usatiuk/EggbotWireless/Electronics/EggbotWireless/EggbotWirelessBOM.xlsx

Sheet: Sheet1
Column1 | Column2 | Column3 | Column4
Source: | C:\Users\stepu\projects\EggbotWireless\Electronics\EggbotWireless\EggbotWireless.sch
Date: | 17.03.2020 17:32:18
Tool: | Eeschema (5.1.5)-3
Generator: | C:\Program Files\KiCad\bin\scripting\plugins/bom_csv_grouped_by_value.py
Component Count: | 90
Individual Components:
Item | Qty | Reference(s) | Value
 |  | A1 | Pololu_Breakout_DRV8825
 |  | A2 | Pololu_Breakout_DRV8825
 |  | C1 | 22pF
 |  | C2 | 4.7uF
 |  | C3 | 22pF
 |  | C4 | 100nf
 |  | C5 | 10uF
 |  | C6 | 3300pF
 |  | C7 | 100nf
 |  | C8 | 100nf
 |  | C9 | 68nF
 |  | C10 | 100nf
 |  | C11 | 10pF
 |  | C12 | 220uF
 |  | C13 | 220uF
 |  | C14 | 100nf
 |  | C15 | 100nf
 |  | C16 | 100nf
 |  | C17 | 10uF
 |  | C18 | 10uF
 |  | C19 | 22pF
 |  | C20 | 100nF
 |  | C21 | 10uF
 |  | D1 | SSB43L
 |  | D2 | SSB43L
 |  | D3 | LED
 |  | D4 | SSB43L
 |  | D5 | SSB43L
 |  | J1 | BATT
 |  | J2 | Conn_01x03_Male
 |  | J3 | USB_B_Micro
 |  | J4 | AVR-ISP-6
 |  | J5 | Conn_01x03_Female
 |  | J6 | Conn_01x05_Male
 |  | JP1 | SolderJumper_2_Bridged
 |  | JP2 | SolderJumper_2_Bridged
 |  | JP3 | SolderJumper_2_Bridged
 |  | L1 | 6.8uH
 |  | L2 | 10uH
 |  | L3 | 6.8uH
 |  | M1
 |  | M2
 |  | M3 | Motor_Servo
 |  | Q1 | FDD8800
 |  | Q2 | 2N7002
 |  | Q3 | IRLML6402
 |  | Q4 | IRLML6402
 |  | Q5 | S8050
 |  | Q6 | S8050
 |  | R1 | 10K
 |  | R2 | 100
 |  | R3 | 1K
 |  | R4 | 1.8K
 |  | R5 | 1K
 |  | R6 | 10K
 |  | R7 | 2.2K
 |  | R8 | 10K
 |  | R9 | 10K
 |  | R10 | 10K
 |  | R11 | 10K
 |  | R12 | 10K
 |  | R13 | 27K
 |  | R14 | 100
 |  | R15 | 0.008
 |  | R16 | 8.45K
 |  | R17 | 10K
 |  | R18 | 10K
 |  | R19 | 10K
 |  | R20 | 10K
 |  | R21 | 510
 |  | R22 | 10K
 |  | R23 | 50K
 |  | R24 | 12K
 |  | R25 | 12K
 |  | R26 | 12K
 |  | R27 | 2.2K
 |  | R28 | 150K
 |  | R29 | 200K
 |  | R30 | 500
 |  | SW1
 |  | U1 | TPS62203DBV
 |  | U2 | ATmega328P-AU
 |  | U3 | DW01
 |  | U4 | DMG4800LSD
 |  | U5 | FT232RL
 |  | U6 | LTC4054ES5-4.2
 |  | U7 | ESP-12E
 |  | U8 | LM3478
 |  | U9 | LM2621
 |  | Y1 | 16MHz
Collated Components:
Item | Qty | Reference(s) | Value
1 | 2 | A1, A2 | Pololu_Breakout_DRV8825
2 | 3 | C1, C3, C19 | 22pF
3 | 1 | C2 | 4.7uF
4 | 7 | C4, C7, C8, C10, C14, C15, C16 | 100nf
5 | 2 | C5, C17 | 10uF
6 | 1 | C6 | 3300pF
7 | 1 | C9 | 68nF
8 | 1 | C11 | 10pF
9 | 2 | C12, C13 | 220uF
10 | 2 | C18, C21 | 10uF
11 | 1 | C20 | 100nF
12 | 4 | D1, D2, D4, D5 | SSB43L
13 | 1 | D3 | LED
14 | 1 | J1 | BATT
15 | 1 | J2 | Conn_01x03_Male
16 | 1 | J3 | USB_B_Micro
17 | 1 | J4 | AVR-ISP-6
18 | 1 | J5 | Conn_01x03_Female
19 | 1 | J6 | Conn_01x05_Male
20 | 3 | JP1, JP2, JP3 | SolderJumper_2_Bridged
21 | 1 | L1 | 6.8uH
22 | 1 | L2 | 10uH
23 | 1 | L3 | 6.8uH
24 | 2 | M1, M2
25 | 1 | M3 | Motor_Servo
26 | 1 | Q1 | FDD8800
27 | 1 | Q2 | 2N7002
28 | 2 | Q3, Q4 | IRLML6402
29 | 2 | Q5, Q6 | S8050
30 | 11 | R1, R6, R8, R9, R10, R11, R12, R17, R18, R20, R22 | 10K
31 | 1 | R2 | 100
32 | 1 | R3 | 1K
33 | 1 | R4 | 1.8K
34 | 1 | R5 | 1K
35 | 2 | R7, R27 | 2.2K
36 | 1 | R13 | 27K
37 | 1 | R14 | 100
38 | 1 | R15 | 0.008
39 | 1 | R16 | 8.45K
40 | 1 | R19 | 10K
41 | 1 | R21 | 510
42 | 1 | R23 | 50K
43 | 3 | R24, R25, R26 | 12K
44 | 1 | R28 | 150K
45 | 1 | R29 | 200K
46 | 1 | R30 | 500
47 | 1 | SW1
48 | 1 | U1 | TPS62203DBV
49 | 1 | U2 | ATmega328P-AU
50 | 1 | U3 | DW01
51 | 1 | U4 | DMG4800LSD
52 | 1 | U5 | FT232RL
53 | 1 | U6 | LTC4054ES5-4.2
54 | 1 | U7 | ESP-12E
55 | 1 | U8 | LM3478
56 | 1 | U9 | LM2621
57 | 1 | Y1 | 16MHz

Sheet: EggbotWireless
Source:,"C:\Users\stepu\projects\EggbotWireless\Electronics\EggbotWireless\EggbotWireless.sch"
Date:,"17.03.2020 17:32:18"
Tool:,"Eeschema (5.1.5)-3"
Generator:,"C:\Program Files\KiCad\bin\scripting\plugins/bom_csv_grouped_by_value.py"
Component Count:,"90"
Individual Components:
Item,"Qty","Reference(s)","Value","LibPart","Footprint","Datasheet","Part"
,"","A1","Pololu_Breakout_DRV8825","EggbotWireless-rescue:Pololu_Breakout_DRV8825-Driver_Motor","Module:Pololu_Breakout-16_15.2x20.3mm","https://www.pololu.com/product/2982",""
,"","A2","Pololu_Breakout_DRV8825","EggbotWireless-rescue:Pololu_Breakout_DRV8825-Driver_Motor","Module:Pololu_Breakout-16_15.2x20.3mm","https://www.pololu.com/product/2982",""
,"","C1","22pF","EggbotWireless-rescue:C-Device-Catfi-rescue","Capacitor_SMD:C_0805_2012Metric_Pad1.15x1.40mm_HandSolder","~",""
,"","C2","4.7uF","EggbotWireless-rescue:C-Device","Capacitor_SMD:C_0805_2012Metric_Pad1.15x1.40mm_HandSolder","~",""
,"","C3","22pF","EggbotWireless-rescue:C-Device-Catfi-rescue","Capacitor_SMD:C_0805_2012Metric_Pad1.15x1.40mm_HandSolder","~",""
,"","C4","100nf","EggbotWireless-rescue:C-Device-Catfi-rescue","Capacitor_SMD:C_0805_2012Metric_Pad1.15x1.40mm_HandSolder","~",""
,"","C5","10uF","EggbotWireless-rescue:C-Device","Capacitor_SMD:C_0805_2012Metric_Pad1.15x1.40mm_HandSolder","~",""
,"","C6","3300pF","EggbotWireless-rescue:C-Device-Catfi-rescue","Capacitor_SMD:C_0805_2012Metric_Pad1.15x1.40mm_HandSolder","~",""
,"","C7","100nf","EggbotWireless-rescue:C-Device-Catfi-rescue","Capacitor_SMD:C_0805_2012Metric_Pad1.15x1.40mm_HandSolder","~",""
,"","C8","100nf","EggbotWireless-rescue:C-Device-Catfi-rescue","Capacitor_SMD:C_0805_2012Metric_Pad1.15x1.40mm_HandSolder","~",""
,"","C9","68nF","EggbotWireless-rescue:C-Device-Catfi-rescue","Capacitor_SMD:C_0805_2012Metric_Pad1.15x1.40mm_HandSolder","~",""
,"","C10","100nf","EggbotWireless-rescue:C-Device-Catfi-rescue","Capacitor_SMD:C_0805_2012Metric_Pad1.15x1.40mm_HandSolder","~",""
,"","C11","10pF","EggbotWireless-rescue:C-Device-Catfi-rescue","Capacitor_SMD:C_0805_2012Metric_Pad1.15x1.40mm_HandSolder","~",""
,"","C12","220uF","EggbotWireless-rescue:CP-Device","Capacitor_SMD:CP_Elec_8x10.5","~",""
,"","C13","220uF","EggbotWireless-rescue:CP-Device","Capacitor_SMD:CP_Elec_8x10.5","~",""
,"","C14","100nf","EggbotWireless-rescue:C-Device-Catfi-rescue","Capacitor_SMD:C_0805_2012Metric_Pad1.15x1.40mm_HandSolder","~",""
,"","C15","100nf","EggbotWireless-rescue:C-Device-Catfi-rescue","Capacitor_SMD:C_0805_2012Metric_Pad1.15x1.40mm_HandSolder","~",""
,"","C16","100nf","EggbotWireless-rescue:C-Device-Catfi-rescue","Capacitor_SMD:C_0805_2012Metric_Pad1.15x1.40mm_HandSolder","~",""
,"","C17","10uF","EggbotWireless-rescue:C-Device","Capacitor_SMD:C_0805_2012Metric_Pad1.15x1.40mm_HandSolder","~",""
,"","C18","10uF","EggbotWireless-rescue:CP-Device","Capacitor_SMD:CP_Elec_4x5.4","~",""
,"","C19","22pF","EggbotWireless-rescue:C-Device-Catfi-rescue","Capacitor_SMD:C_0805_2012Metric_Pad1.15x1.40mm_HandSolder","~",""
,"","C20","100nF","EggbotWireless-rescue:C-Device-Catfi-rescue","Capacitor_SMD:C_0805_2012Metric_Pad1.15x1.40mm_HandSolder","~",""
,"","C21","10uF","EggbotWireless-rescue:CP-Device","Capacitor_SMD:CP_Elec_4x5.4","~",""
,"","D1","SSB43L","EggbotWireless-rescue:D_Schottky-Device","Diode_SMD:D_SMB_Handsoldering","~",""
,"","D2","SSB43L","EggbotWireless-rescue:D_Schottky-Device","Diode_SMD:D_SMB_Handsoldering","~",""
,"","D3","LED","EggbotWireless-rescue:LED-Device","Diode_SMD:D_0805_2012Metric_Pad1.15x1.40mm_HandSolder","~",""
,"","D4","SSB43L","EggbotWireless-rescue:D_Schottky-Device","Diode_SMD:D_SMB_Handsoldering","~",""
,"","D5","SSB43L","EggbotWireless-rescue:D_Schottky-Device","Diode_SMD:D_SMB_Handsoldering","~",""
,"","J1","BATT","EggbotWireless-rescue:Conn_01x02_Female-Connector-Catfi-rescue","Connector_PinHeader_2.54mm:PinHeader_1x02_P2.54mm_Vertical","~",""
,"","J2","Conn_01x03_Male","EggbotWireless-rescue:Conn_01x03_Male-Connector","Connector_PinHeader_2.54mm:PinHeader_1x03_P2.54mm_Vertical","~",""
,"","J3","USB_B_Micro","EggbotWireless-rescue:USB_B_Micro-Connector-Catfi-rescue","Connector_USB:USB_Micro-B_Molex-105017-0001","~",""
,"","J4","AVR-ISP-6","EggbotWireless-rescue:AVR-ISP-6-Connector","Connector_PinHeader_2.54mm:PinHeader_2x03_P2.54mm_Vertical"," ~",""
,"","J5","Conn_01x03_Female","EggbotWireless-rescue:Conn_01x03_Female-Connector","Connector_PinHeader_2.54mm:PinHeader_1x03_P2.54mm_Vertical","~",""
,"","J6","Conn_01x05_Male","EggbotWireless-rescue:Conn_01x05_Male-Connector","Connector_PinHeader_2.54mm:PinHeader_1x05_P2.54mm_Vertical","~",""
,"","JP1","SolderJumper_2_Bridged","EggbotWireless-rescue:SolderJumper_2_Bridged-Jumper","Jumper:SolderJumper-2_P1.3mm_Bridged_Pad1.0x1.5mm","~",""
,"","JP2","SolderJumper_2_Bridged","EggbotWireless-rescue:SolderJumper_2_Bridged-Jumper","Jumper:SolderJumper-2_P1.3mm_Bridged_Pad1.0x1.5mm","~",""
,"","JP3","SolderJumper_2_Bridged","EggbotWireless-rescue:SolderJumper_2_Bridged-Jumper","Jumper:SolderJumper-2_P1.3mm_Bridged_Pad1.0x1.5mm","~",""
,"","L1","6.8uH","EggbotWireless-rescue:L-Device","Inductor_SMD:L_7.3x7.3_H4.5","~",""
,"","L2","10uH","EggbotWireless-rescue:L-Device","Inductor_SMD:L_6.3x6.3_H3","~",""
,"","L3","6.8uH","EggbotWireless-rescue:L-Device","Inductor_SMD:L_6.3x6.3_H3","~","CKCS6028"
,"","M1","","EggbotWireless-rescue:Stepper_Motor_bipolar-Motor","Connector_PinHeader_2.54mm:PinHeader_1x04_P2.54mm_Vertical","http://www.infineon.com/dgdl/Application-Note-TLE8110EE_driving_UniPolarStepperMotor_V1.1.pdf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",""
,"","M2","","EggbotWireless-rescue:Stepper_Motor_bipolar-Motor","Connector_PinHeader_2.54mm:PinHeader_1x04_P2.54mm_Vertical","http://www.infineon.com/dgdl/Application-Note-TLE8110EE_driving_UniPolarStepperMotor_V1.1.pdf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",""
,"","M3","Motor_Servo","EggbotWireless-rescue:Motor_Servo-Motor","Connector_PinHeader_2.54mm:PinHeader_1x03_P2.54mm_Vertical","http://forums.parallax.com/uploads/attachments/46831/74481.png",""
,"","Q1","FDD8800","EggbotWireless-rescue:Q_NMOS_GDS-Device","Package_TO_SOT_SMD:TO-252-2","~",""
,"","Q2","2N7002","EggbotWireless-rescue:2N7002-Transistor_FET","Package_TO_SOT_SMD:SOT-23","https://www.fairchildsemi.com/datasheets/2N/2N7002.pdf",""
,"","Q3","IRLML6402","EggbotWireless-rescue:IRLML6402-Transistor_FET","Package_TO_SOT_SMD:SOT-23","https://www.infineon.com/dgdl/irlml6402pbf.pdf?fileId=5546d462533600a401535668d5c2263c",""
,"","Q4","IRLML6402","EggbotWireless-rescue:IRLML6402-Transistor_FET","Package_TO_SOT_SMD:SOT-23","https://www.infineon.com/dgdl/irlml6402pbf.pdf?fileId=5546d462533600a401535668d5c2263c",""
,"","Q5","S8050","EggbotWireless-rescue:Q_NPN_BEC-Device","Package_TO_SOT_SMD:SOT-23","~",""
,"","Q6","S8050","EggbotWireless-rescue:Q_NPN_BEC-Device","Package_TO_SOT_SMD:SOT-23","~",""
,"","R1","10K","EggbotWireless-rescue:R-Device-Catfi-rescue","Resistor_SMD:R_0805_2012Metric_Pad1.15x1.40mm_HandSolder","~",""
,"","R2","100","EggbotWireless-rescue:R-Device-Catfi-rescue","Resistor_SMD:R_0805_2012Metric_Pad1.15x1.40mm_HandSolder","~",""
,"","R3","1K","EggbotWireless-rescue:R-Device-Catfi-rescue","Resistor_SMD:R_0805_2012Metric_Pad1.15x1.40mm_HandSolder","~",""
,"","R4","1.8K","EggbotWireless-rescue:R-Device","Resistor_SMD:R_0805_2012Metric_Pad1.15x1.40mm_HandSolder","~",""
,"","R5","1K","EggbotWireless-rescue:R-Device","Resistor_SMD:R_0805_2012Metric_Pad1.15x1.40mm_HandSolder","~",""
,"","R6","10K","EggbotWireless-rescue:R-Device-Catfi-rescue","Resistor_SMD:R_0805_2012Metric_Pad1.15x1.40mm_HandSolder","~",""
,"","R7","2.2K","EggbotWireless-rescue:R-Device-Catfi-rescue","Resistor_SMD:R_0805_2012Metric_Pad1.15x1.40mm_HandSolder","~",""
,"","R8","10K","EggbotWireless-rescue:R-Device-Catfi-rescue","Resistor_SMD:R_0805_2012Metric_Pad1.15x1.40mm_HandSolder","~",""
,"","R9","10K","EggbotWireless-rescue:R-Device-Catfi-rescue","Resistor_SMD:R_0805_2012Metric_Pad1.15x1.40mm_HandSolder","~",""
,"","R10","10K","EggbotWireless-rescue:R-Device-Catfi-rescue","Resistor_SMD:R_0805_2012Metric_Pad1.15x1.40mm_HandSolder","~",""
,"","R11","10K","EggbotWireless-rescue:R-Device-Catfi-rescue","Resistor_SMD:R_0805_2012Metric_Pad1.15x1.40mm_HandSolder","~",""
,"","R12","10K","EggbotWireless-rescue:R-Device-Catfi-rescue","Resistor_SMD:R_0805_2012Metric_Pad1.15x1.40mm_HandSolder","~",""
,"","R13","27K","EggbotWireless-rescue:R-Device","Resistor_SMD:R_0805_2012Metric_Pad1.15x1.40mm_HandSolder","~",""
,"","R14","100","EggbotWireless-rescue:R-Device","Resistor_SMD:R_0805_2012Metric_Pad1.15x1.40mm_HandSolder","~",""
,"","R15","0.008","EggbotWireless-rescue:R-Device","Resistor_SMD:R_1206_3216Metric_Pad1.42x1.75mm_HandSolder","~",""
,"","R16","8.45K","EggbotWireless-rescue:R-Device","Resistor_SMD:R_0805_2012Metric_Pad1.15x1.40mm_HandSolder","~",""
,"","R17","10K","EggbotWireless-rescue:R-Device-Catfi-rescue","Resistor_SMD:R_0805_2012Metric_Pad1.15x1.40mm_HandSolder","~",""
,"","R18","10K","EggbotWireless-rescue:R-Device-Catfi-rescue","Resistor_SMD:R_0805_2012Metric_Pad1.15x1.40mm_HandSolder","~",""
,"","R19","10K","EggbotWireless-rescue:R-Device","Resistor_SMD:R_0805_2012Metric_Pad1.15x1.40mm_HandSolder","~",""
,"","R20","10K","EggbotWireless-rescue:R-Device-Catfi-rescue","Resistor_SMD:R_0805_2012Metric_Pad1.15x1.40mm_HandSolder","~",""
,"","R21","510","EggbotWireless-rescue:R-Device-Catfi-rescue","Resistor_SMD:R_0805_2012Metric_Pad1.15x1.40mm_HandSolder","~",""
,"","R22","10K","EggbotWireless-rescue:R-Device-Catfi-rescue","Resistor_SMD:R_0805_2012Metric_Pad1.15x1.40mm_HandSolder","~",""
,"","R23","50K","EggbotWireless-rescue:R-Device","Resistor_SMD:R_0805_2012Metric_Pad1.15x1.40mm_HandSolder","~",""
,"","R24","12K","EggbotWireless-rescue:R-Device-Catfi-rescue","Resistor_SMD:R_0805_2012Metric_Pad1.15x1.40mm_HandSolder","~",""
,"","R25","12K","EggbotWireless-rescue:R-Device-Catfi-rescue","Resistor_SMD:R_0805_2012Metric_Pad1.15x1.40mm_HandSolder","~",""
,"","R26","12K","EggbotWireless-rescue:R-Device-Catfi-rescue","Resistor_SMD:R_0805_2012Metric_Pad1.15x1.40mm_HandSolder","~",""
,"","R27","2.2K","EggbotWireless-rescue:R-Device-Catfi-rescue","Resistor_SMD:R_0805_2012Metric_Pad1.15x1.40mm_HandSolder","~",""
,"","R28","150K","EggbotWireless-rescue:R-Device","Resistor_SMD:R_0805_2012Metric_Pad1.15x1.40mm_HandSolder","~",""
,"","R29","200K","EggbotWireless-rescue:R-Device","Resistor_SMD:R_0805_2012Metric_Pad1.15x1.40mm_HandSolder","~",""
,"","R30","500","EggbotWireless-rescue:R-Device","Resistor_SMD:R_0805_2012Metric_Pad1.15x1.40mm_HandSolder","~",""
,"","SW1","","EggbotWireless-rescue:SW_SPDT-Switch","Button_Switch_THT:SW_CuK_OS102011MA1QN1_SPDT_Angled","~",""
,"","U1","TPS62203DBV","EggbotWireless-rescue:TPS62203DBV-Regulator_Switching","Package_TO_SOT_SMD:SOT-23-5","http://www.ti.com/lit/ds/symlink/tps62201.pdf",""
,"","U2","ATmega328P-AU","EggbotWireless-rescue:ATmega328P-AU-MCU_Microchip_ATmega","Package_QFP:TQFP-32_7x7mm_P0.8mm","http://ww1.microchip.com/downloads/en/DeviceDoc/ATmega328_P%20AVR%20MCU%20with%20picoPower%20Technology%20Data%20Sheet%2040001984A.pdf",""
,"","U3","DW01","EggbotWireless-rescue:DW01-DW01-Catfi-rescue","Package_TO_SOT_SMD:SOT-23-6_Handsoldering","",""
,"","U4","DMG4800LSD","DMG4800LSD:DMG4800LSD","Package_SO:SO-8_3.9x4.9mm_P1.27mm","",""
,"","U5","FT232RL","EggbotWireless-rescue:FT232RL-Interface_USB","Package_SO:SSOP-28_5.3x10.2mm_P0.65mm","http://www.ftdichip.com/Products/ICs/FT232RL.htm",""
,"","U6","LTC4054ES5-4.2","EggbotWireless-rescue:LTC4054ES5-4.2-Battery_Management-Catfi-rescue","Package_TO_SOT_SMD:TSOT-23-5","http://cds.linear.com/docs/en/datasheet/405442xf.pdf",""
,"","U7","ESP-12E","EggbotWireless-rescue:ESP-12E-RF_Module-Catfi-rescue","RF_Module:ESP-12E","http://wiki.ai-thinker.com/_media/esp8266/esp8266_series_modules_user_manual_v1.1.pdf",""
,"","U8","LM3478","LM3478:LM3478","Package_SO:VSSOP-8_3.0x3.0mm_P0.65mm","",""
,"","U9","LM2621","LM2621:LM2621","Package_SO:VSSOP-8_3.0x3.0mm_P0.65mm","",""
,"","Y1","16MHz","EggbotWireless-rescue:Crystal-Device","Crystal:Crystal_HC49-4H_Vertical","~",""
Collated Components:
Item,"Qty","Reference(s)","Value","LibPart","Footprint","Datasheet","Part"
1,"2","A1, A2","Pololu_Breakout_DRV8825","EggbotWireless-rescue:Pololu_Breakout_DRV8825-Driver_Motor","Module:Pololu_Breakout-16_15.2x20.3mm","https://www.pololu.com/product/2982",""
2,"3","C1, C3, C19","22pF","EggbotWireless-rescue:C-Device-Catfi-rescue","Capacitor_SMD:C_0805_2012Metric_Pad1.15x1.40mm_HandSolder","~",""
3,"1","C2","4.7uF","EggbotWireless-rescue:C-Device","Capacitor_SMD:C_0805_2012Metric_Pad1.15x1.40mm_HandSolder","~",""
4,"7","C4, C7, C8, C10, C14, C15, C16","100nf","EggbotWireless-rescue:C-Device-Catfi-rescue","Capacitor_SMD:C_0805_2012Metric_Pad1.15x1.40mm_HandSolder","~",""
5,"2","C5, C17","10uF","EggbotWireless-rescue:C-Device","Capacitor_SMD:C_0805_2012Metric_Pad1.15x1.40mm_HandSolder","~",""
6,"1","C6","3300pF","EggbotWireless-rescue:C-Device-Catfi-rescue","Capacitor_SMD:C_0805_2012Metric_Pad1.15x1.40mm_HandSolder","~",""
7,"1","C9","68nF","EggbotWireless-rescue:C-Device-Catfi-rescue","Capacitor_SMD:C_0805_2012Metric_Pad1.15x1.40mm_HandSolder","~",""
8,"1","C11","10pF","EggbotWireless-rescue:C-Device-Catfi-rescue","Capacitor_SMD:C_0805_2012Metric_Pad1.15x1.40mm_HandSolder","~",""
9,"2","C12, C13","220uF","EggbotWireless-rescue:CP-Device","Capacitor_SMD:CP_Elec_8x10.5","~",""
10,"2","C18, C21","10uF","EggbotWireless-rescue:CP-Device","Capacitor_SMD:CP_Elec_4x5.4","~",""
11,"1","C20","100nF","EggbotWireless-rescue:C-Device-Catfi-rescue","Capacitor_SMD:C_0805_2012Metric_Pad1.15x1.40mm_HandSolder","~",""
12,"4","D1, D2, D4, D5","SSB43L","EggbotWireless-rescue:D_Schottky-Device","Diode_SMD:D_SMB_Handsoldering","~",""
13,"1","D3","LED","EggbotWireless-rescue:LED-Device","Diode_SMD:D_0805_2012Metric_Pad1.15x1.40mm_HandSolder","~",""
14,"1","J1","BATT","EggbotWireless-rescue:Conn_01x02_Female-Connector-Catfi-rescue","Connector_PinHeader_2.54mm:PinHeader_1x02_P2.54mm_Vertical","~",""
15,"1","J2","Conn_01x03_Male","EggbotWireless-rescue:Conn_01x03_Male-Connector","Connector_PinHeader_2.54mm:PinHeader_1x03_P2.54mm_Vertical","~",""
16,"1","J3","USB_B_Micro","EggbotWireless-rescue:USB_B_Micro-Connector-Catfi-rescue","Connector_USB:USB_Micro-B_Molex-105017-0001","~",""
17,"1","J4","AVR-ISP-6","EggbotWireless-rescue:AVR-ISP-6-Connector","Connector_PinHeader_2.54mm:PinHeader_2x03_P2.54mm_Vertical"," ~",""
18,"1","J5","Conn_01x03_Female","EggbotWireless-rescue:Conn_01x03_Female-Connector","Connector_PinHeader_2.54mm:PinHeader_1x03_P2.54mm_Vertical","~",""
19,"1","J6","Conn_01x05_Male","EggbotWireless-rescue:Conn_01x05_Male-Connector","Connector_PinHeader_2.54mm:PinHeader_1x05_P2.54mm_Vertical","~",""
20,"3","JP1, JP2, JP3","SolderJumper_2_Bridged","EggbotWireless-rescue:SolderJumper_2_Bridged-Jumper","Jumper:SolderJumper-2_P1.3mm_Bridged_Pad1.0x1.5mm","~",""
21,"1","L1","6.8uH","EggbotWireless-rescue:L-Device","Inductor_SMD:L_7.3x7.3_H4.5","~",""
22,"1","L2","10uH","EggbotWireless-rescue:L-Device","Inductor_SMD:L_6.3x6.3_H3","~",""
23,"1","L3","6.8uH","EggbotWireless-rescue:L-Device","Inductor_SMD:L_6.3x6.3_H3","~","CKCS6028"
24,"2","M1, M2","","EggbotWireless-rescue:Stepper_Motor_bipolar-Motor","Connector_PinHeader_2.54mm:PinHeader_1x04_P2.54mm_Vertical","http://www.infineon.com/dgdl/Application-Note-TLE8110EE_driving_UniPolarStepperMotor_V1.1.pdf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",""
25,"1","M3","Motor_Servo","EggbotWireless-rescue:Motor_Servo-Motor","Connector_PinHeader_2.54mm:PinHeader_1x03_P2.54mm_Vertical","http://forums.parallax.com/uploads/attachments/46831/74481.png",""
26,"1","Q1","FDD8800","EggbotWireless-rescue:Q_NMOS_GDS-Device","Package_TO_SOT_SMD:TO-252-2","~",""
27,"1","Q2","2N7002","EggbotWireless-rescue:2N7002-Transistor_FET","Package_TO_SOT_SMD:SOT-23","https://www.fairchildsemi.com/datasheets/2N/2N7002.pdf",""
28,"2","Q3, Q4","IRLML6402","EggbotWireless-rescue:IRLML6402-Transistor_FET","Package_TO_SOT_SMD:SOT-23","https://www.infineon.com/dgdl/irlml6402pbf.pdf?fileId=5546d462533600a401535668d5c2263c",""
29,"2","Q5, Q6","S8050","EggbotWireless-rescue:Q_NPN_BEC-Device","Package_TO_SOT_SMD:SOT-23","~",""
30,"11","R1, R6, R8, R9, R10, R11, R12, R17, R18, R20, R22","10K","EggbotWireless-rescue:R-Device-Catfi-rescue","Resistor_SMD:R_0805_2012Metric_Pad1.15x1.40mm_HandSolder","~",""
31,"1","R2","100","EggbotWireless-rescue:R-Device-Catfi-rescue","Resistor_SMD:R_0805_2012Metric_Pad1.15x1.40mm_HandSolder","~",""
32,"1","R3","1K","EggbotWireless-rescue:R-Device-Catfi-rescue","Resistor_SMD:R_0805_2012Metric_Pad1.15x1.40mm_HandSolder","~",""
33,"1","R4","1.8K","EggbotWireless-rescue:R-Device","Resistor_SMD:R_0805_2012Metric_Pad1.15x1.40mm_HandSolder","~",""
34,"1","R5","1K","EggbotWireless-rescue:R-Device","Resistor_SMD:R_0805_2012Metric_Pad1.15x1.40mm_HandSolder","~",""
35,"2","R7, R27","2.2K","EggbotWireless-rescue:R-Device-Catfi-rescue","Resistor_SMD:R_0805_2012Metric_Pad1.15x1.40mm_HandSolder","~",""
36,"1","R13","27K","EggbotWireless-rescue:R-Device","Resistor_SMD:R_0805_2012Metric_Pad1.15x1.40mm_HandSolder","~",""
37,"1","R14","100","EggbotWireless-rescue:R-Device","Resistor_SMD:R_0805_2012Metric_Pad1.15x1.40mm_HandSolder","~",""
38,"1","R15","0.008","EggbotWireless-rescue:R-Device","Resistor_SMD:R_1206_3216Metric_Pad1.42x1.75mm_HandSolder","~",""
39,"1","R16","8.45K","EggbotWireless-rescue:R-Device","Resistor_SMD:R_0805_2012Metric_Pad1.15x1.40mm_HandSolder","~",""
40,"1","R19","10K","EggbotWireless-rescue:R-Device","Resistor_SMD:R_0805_2012Metric_Pad1.15x1.40mm_HandSolder","~",""
41,"1","R21","510","EggbotWireless-rescue:R-Device-Catfi-rescue","Resistor_SMD:R_0805_2012Metric_Pad1.15x1.40mm_HandSolder","~",""
42,"1","R23","50K","EggbotWireless-rescue:R-Device","Resistor_SMD:R_0805_2012Metric_Pad1.15x1.40mm_HandSolder","~",""
43,"3","R24, R25, R26","12K","EggbotWireless-rescue:R-Device-Catfi-rescue","Resistor_SMD:R_0805_2012Metric_Pad1.15x1.40mm_HandSolder","~",""
44,"1","R28","150K","EggbotWireless-rescue:R-Device","Resistor_SMD:R_0805_2012Metric_Pad1.15x1.40mm_HandSolder","~",""
45,"1","R29","200K","EggbotWireless-rescue:R-Device","Resistor_SMD:R_0805_2012Metric_Pad1.15x1.40mm_HandSolder","~",""
46,"1","R30","500","EggbotWireless-rescue:R-Device","Resistor_SMD:R_0805_2012Metric_Pad1.15x1.40mm_HandSolder","~",""
47,"1","SW1","","EggbotWireless-rescue:SW_SPDT-Switch","Button_Switch_THT:SW_CuK_OS102011MA1QN1_SPDT_Angled","~",""
48,"1","U1","TPS62203DBV","EggbotWireless-rescue:TPS62203DBV-Regulator_Switching","Package_TO_SOT_SMD:SOT-23-5","http://www.ti.com/lit/ds/symlink/tps62201.pdf",""
49,"1","U2","ATmega328P-AU","EggbotWireless-rescue:ATmega328P-AU-MCU_Microchip_ATmega","Package_QFP:TQFP-32_7x7mm_P0.8mm","http://ww1.microchip.com/downloads/en/DeviceDoc/ATmega328_P%20AVR%20MCU%20with%20picoPower%20Technology%20Data%20Sheet%2040001984A.pdf",""
50,"1","U3","DW01","EggbotWireless-rescue:DW01-DW01-Catfi-rescue","Package_TO_SOT_SMD:SOT-23-6_Handsoldering","",""
51,"1","U4","DMG4800LSD","DMG4800LSD:DMG4800LSD","Package_SO:SO-8_3.9x4.9mm_P1.27mm","",""
52,"1","U5","FT232RL","EggbotWireless-rescue:FT232RL-Interface_USB","Package_SO:SSOP-28_5.3x10.2mm_P0.65mm","http://www.ftdichip.com/Products/ICs/FT232RL.htm",""
53,"1","U6","LTC4054ES5-4.2","EggbotWireless-rescue:LTC4054ES5-4.2-Battery_Management-Catfi-rescue","Package_TO_SOT_SMD:TSOT-23-5","http://cds.linear.com/docs/en/datasheet/405442xf.pdf",""
54,"1","U7","ESP-12E","EggbotWireless-rescue:ESP-12E-RF_Module-Catfi-rescue","RF_Module:ESP-12E","http://wiki.ai-thinker.com/_media/esp8266/esp8266_series_modules_user_manual_v1.1.pdf",""
55,"1","U8","LM3478","LM3478:LM3478","Package_SO:VSSOP-8_3.0x3.0mm_P0.65mm","",""
56,"1","U9","LM2621","LM2621:LM2621","Package_SO:VSSOP-8_3.0x3.0mm_P0.65mm","",""
57,"1","Y1","16MHz","EggbotWireless-rescue:Crystal-Device","Crystal:Crystal_HC49-4H_Vertical","~",""
