usatiuk/EggbotWireless/Mechanics/eggbot.FCStd

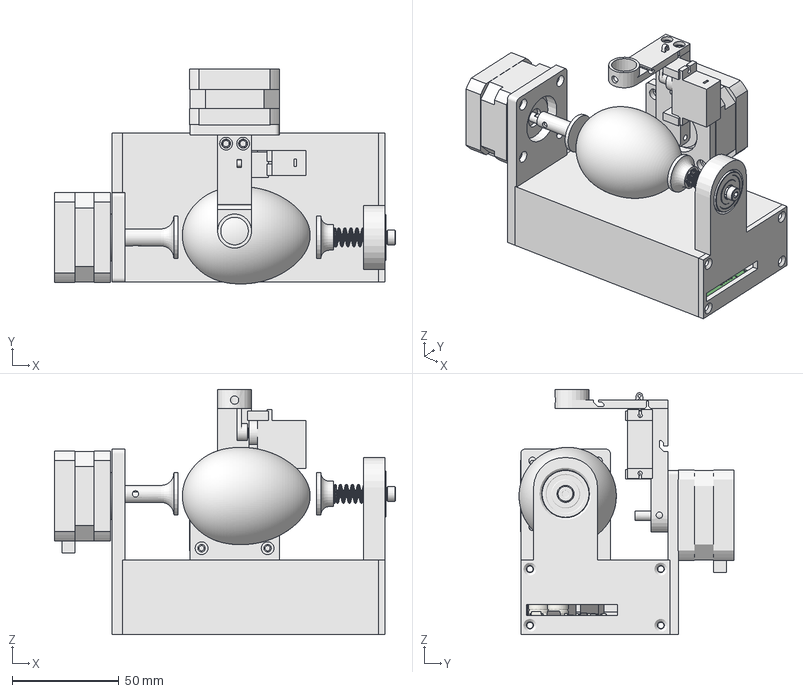
[picture p3: CAD file, 2020-12-06]
Mechanics/eggbot.FCStd
160.0 x 100.8 x 115.0 mm
Case
StepperMount
BearingMount
PenStepperMount
StepperEgg
BearingScrew
StepperServoMount
BearingEgg
PenHolder
M4NYLOC
M4Screw30mm
Spring
SG90-1-arm-horn
Servo-SG90
608ZZ_Ball_Bearing
NEMA-17_Stepper_Motor_26mm_with_connector
NEMA-17_Stepper_Motor_26mm_with_connector001
Egg_v1
