usatiuk/EggbotWireless/Electronics/EggbotWireless/EggbotWireless.kicad_pcb

## KiCad design Electronics/EggbotWireless/EggbotWireless.kicad_pcb (2020-12-05)

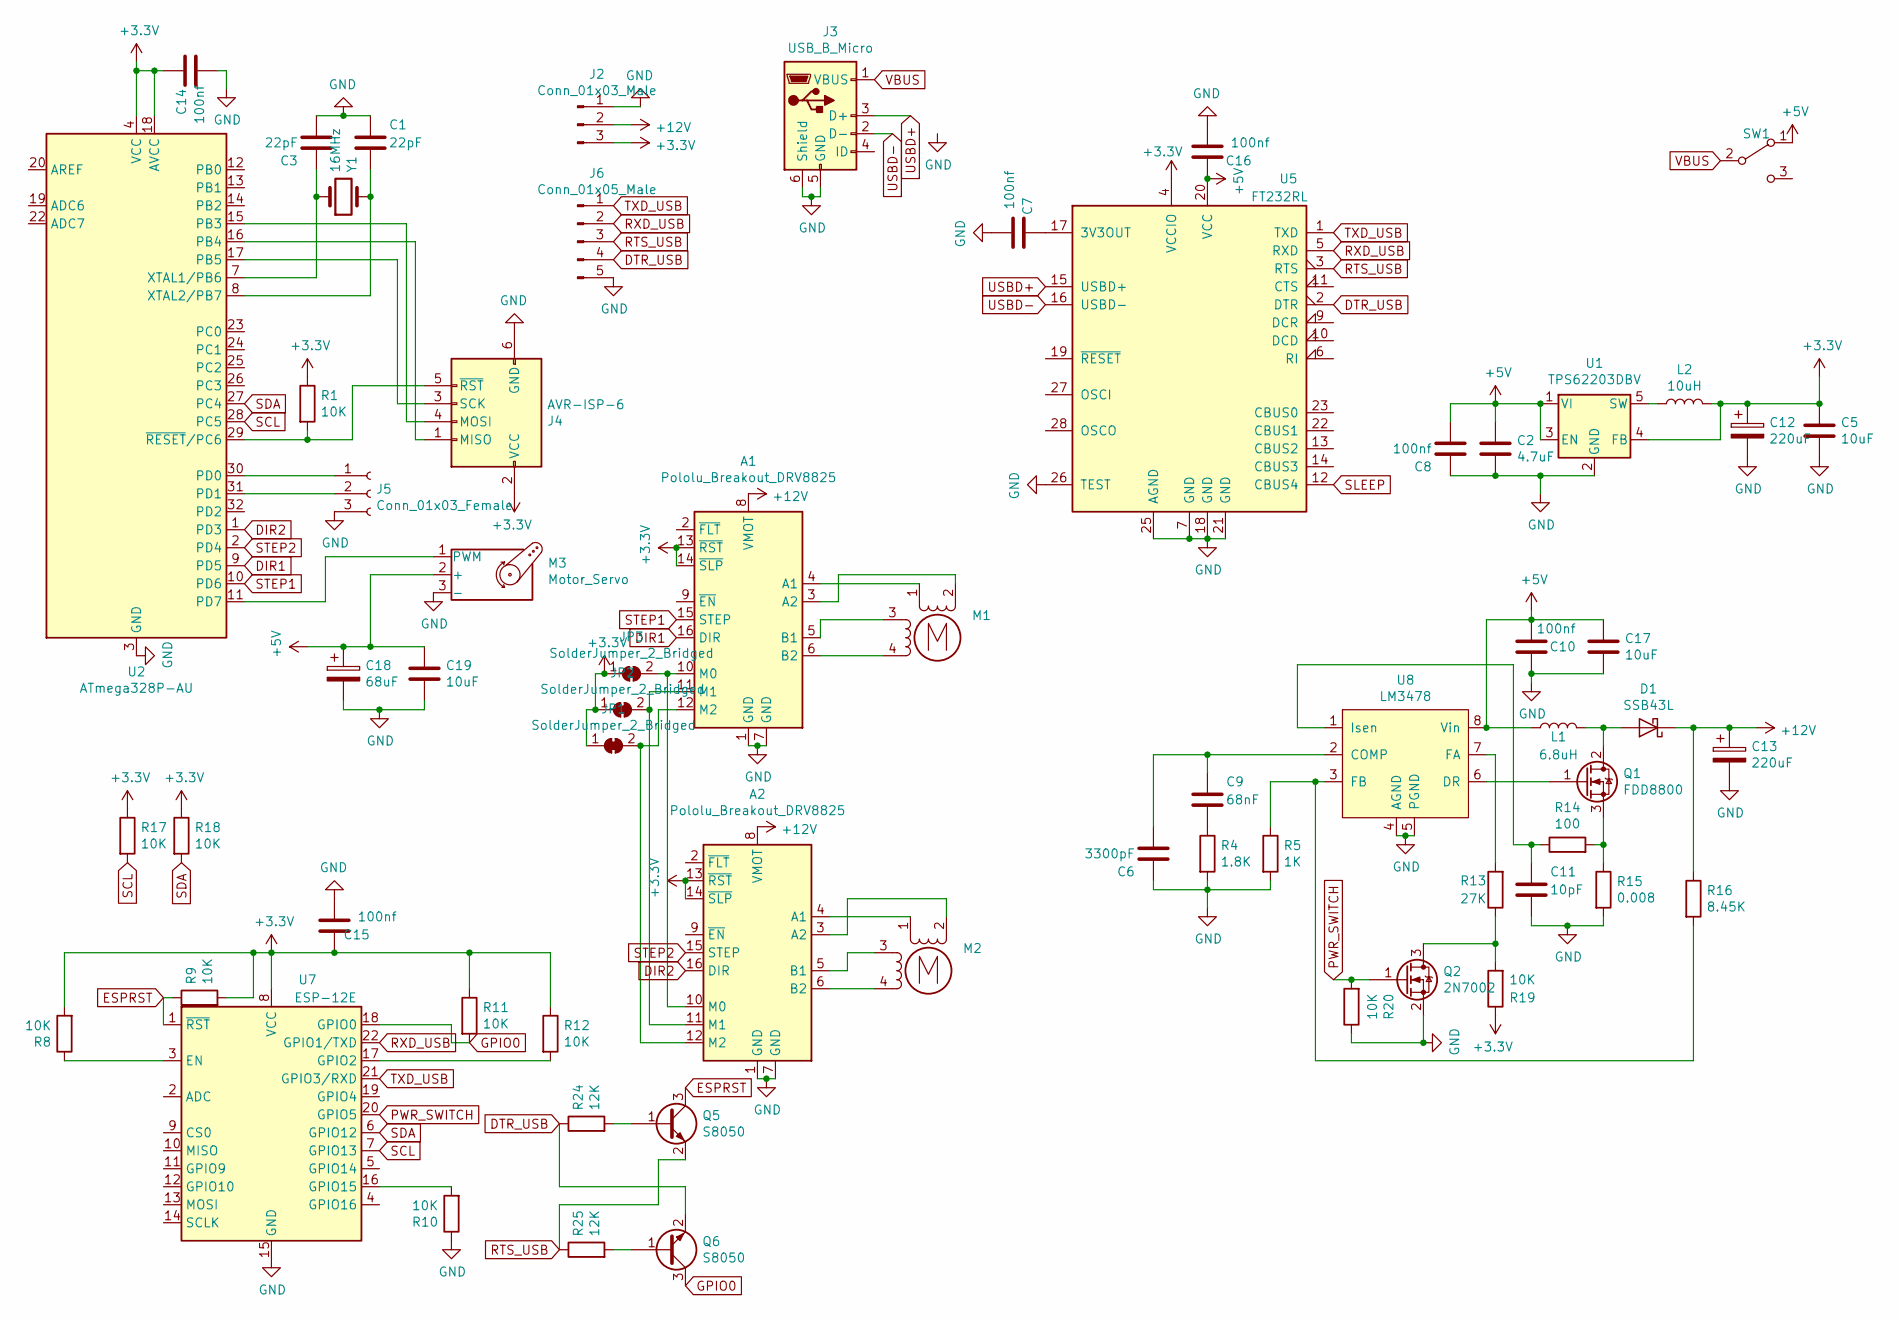
[picture p4: schematic EggbotWireless.sch]

Parts:
A1, A2: Pololu_Breakout_DRV8825; Pololu_Breakout-16_15.2x20.3mm
C1, C3: 22pF; C_0805_2012Metric_Pad1.15x1.40mm_HandSolder
C2: 4.7uF; C_0805_2012Metric_Pad1.15x1.40mm_HandSolder
C5, C17: 10uF; C_0805_2012Metric_Pad1.15x1.40mm_HandSolder
C6: 3300pF; C_0805_2012Metric_Pad1.15x1.40mm_HandSolder
C7, C10, C14, C15, C16: 100nf; C_0805_2012Metric_Pad1.15x1.40mm_HandSolder
C8: 100nf; C_0805_2012Metric_Pad1.18x1.45mm_HandSolder
C9: 68nF; C_0805_2012Metric_Pad1.15x1.40mm_HandSolder
C11: 10pF; C_0805_2012Metric_Pad1.15x1.40mm_HandSolder
C12, C13: 220uF; CP_Elec_8x10.5
C18: 68uF; CP_Elec_4x5.8
C19: 10uF; C_0805_2012Metric_Pad1.18x1.45mm_HandSolder
D1: SSB43L; D_SMB_Handsoldering
J2: Conn_01x03_Male; PinHeader_1x03_P2.54mm_Vertical
J3: USB_B_Micro; USB_Micro-B_Molex-105017-0001
J4: AVR-ISP-6; PinHeader_2x03_P2.54mm_Vertical
J5: Conn_01x03_Female; PinHeader_1x03_P2.54mm_Vertical
J6: Conn_01x05_Male; PinHeader_1x05_P2.54mm_Vertical
JP1, JP2, JP3: SolderJumper_2_Bridged; SolderJumper-2_P1.3mm_Bridged_Pad1.0x1.5mm
L1: 6.8uH; L_7.3x7.3_H4.5
L2: 10uH; L_6.3x6.3_H3
M1, M2: PinHeader_1x04_P2.54mm_Vertical
M3: Motor_Servo; PinHeader_1x03_P2.54mm_Vertical
Q1: FDD8800; TO-252-2
Q2: 2N7002; SOT-23
Q5, Q6: S8050; SOT-23
R1, R8, R9, R10, R11, R12, R17, R18, R19, R20: 10K; R_0805_2012Metric_Pad1.15x1.40mm_HandSolder
R4: 1.8K; R_0805_2012Metric_Pad1.15x1.40mm_HandSolder
R5: 1K; R_0805_2012Metric_Pad1.15x1.40mm_HandSolder
R13: 27K; R_0805_2012Metric_Pad1.15x1.40mm_HandSolder
R14: 100; R_0805_2012Metric_Pad1.15x1.40mm_HandSolder
R15: 0.008; R_1206_3216Metric_Pad1.42x1.75mm_HandSolder
R16: 8.45K; R_0805_2012Metric_Pad1.15x1.40mm_HandSolder
R24, R25: 12K; R_0805_2012Metric_Pad1.15x1.40mm_HandSolder
SW1: SW_CuK_OS102011MA1QN1_SPDT_Angled
U1: TPS62203DBV; SOT-23-5
U2: ATmega328P-AU; TQFP-32_7x7mm_P0.8mm
U5: FT232RL; SSOP-28_5.3x10.2mm_P0.65mm
U7: ESP-12E
U8: LM3478; VSSOP-8_3.0x3.0mm_P0.65mm
Y1: 16MHz; Crystal_HC49-4H_Vertical

Connections:
+3V3: A1.13 (~RST), A1.14 (~SLP), A2.13 (~RST), A2.14 (~SLP), C5.1, C12.1, C14.2, C15.2, J2.3, J4.2 (VCC), JP1.1 (A), JP2.1 (A), JP3.1 (A), L2.2, R1.1, R8.2, R9.2, R11.1, R12.1, R17.1, R18.1, R19.1, U1.4 (FB), U2.4 (VCC), U2.6 (VCC), U2.18 (AVCC), U5.4 (VCCIO), U7.8 (VCC)
+5V: C2.1, C8.1, C10.1, C16.2, C17.1, C18.1, C19.1, L1.1, M3.2 (+), SW1.1 (A), U1.1 (VI), U1.3 (EN), U5.20 (VCC), U8.8 (Vin)
+12V: A1.8 (VMOT), A2.8 (VMOT), C13.1, D1.1 (K), J2.2, R16.1
DIR1: A1.16 (DIR), U2.9 (PD5)
DIR2: A2.16 (DIR), U2.1 (PD3)
DTR_USB: J6.4, Q6.2 (E), R24.1, U5.2 (DTR)
ESPRST: Q5.3 (C), R9.1, U7.1 (~RST)
GND: A1.1 (GND), A1.7 (GND), A2.1 (GND), A2.7 (GND), C1.2, C2.2, C3.1, C5.2, C6.2, C7.1, C8.2, C10.2, C11.1, C12.2, C13.2, C14.1, C15.1, C16.1, C17.2, C18.2, C19.2, J2.1, J3.5 (GND), J3.6 (Shield), J4.6 (GND), J5.3, J6.5, M3.3 (-), Q2.2 (S), R4.2, R5.2, R10.1, R15.2, R20.1, U1.2 (GND), U2.3 (GND), U2.5 (GND), U2.21 (GND), U5.7 (GND), U5.18 (GND), U5.21 (GND), U5.25 (AGND), U5.26 (TEST), U7.15 (GND), U8.4 (AGND), U8.5 (PGND)
GPIO0: Q6.3 (C), R11.2, U7.18 (GPIO0)
unnamed: A1.3 (A2), M1.2 (-)
unnamed: A1.4 (A1), M1.1
unnamed: A1.5 (B1), M1.3
unnamed: A1.6 (B2), M1.4
unnamed: A1.10 (M0), A2.10 (M0), JP3.2 (B)
unnamed: A1.11 (M1), A2.11 (M1), JP2.2 (B)
unnamed: A1.12 (M2), A2.12 (M2), JP1.2 (B)
unnamed: A2.3 (A2), M2.2 (-)
unnamed: A2.4 (A1), M2.1
unnamed: A2.5 (B1), M2.3
unnamed: A2.6 (B2), M2.4
unnamed: C1.1, U2.8 (XTAL2/PB7), Y1.2
unnamed: C3.2, U2.7 (XTAL1/PB6), Y1.1
unnamed: C6.1, C9.2, U8.2 (COMP)
unnamed: C7.2, U5.17 (3V3OUT)
unnamed: C9.1, R4.1
unnamed: C11.2, R14.1, U8.1 (Isen)
unnamed: D1.2 (A), L1.2, Q1.2 (D)
unnamed: J4.1 (MISO), U2.16 (PB4)
unnamed: J4.3 (SCK), U2.17 (PB5)
unnamed: J4.4 (MOSI), U2.15 (PB3)
unnamed: J4.5 (~RST), R1.2, U2.29 (~RESET~/PC6)
unnamed: J5.1, U2.30 (PD0)
unnamed: J5.2, U2.31 (PD1)
unnamed: L2.1, U1.5 (SW)
unnamed: M3.1 (PWM), U2.11 (PD7)
unnamed: Q1.1 (G), U8.6 (DR)
unnamed: Q1.3 (S), R14.2, R15.1
unnamed: Q2.3 (D), R13.1, R19.2
unnamed: Q5.1 (B), R24.2
unnamed: Q6.1 (B), R25.2
unnamed: R8.1, U7.3 (EN)
unnamed: R10.2, U7.16 (GPIO15)
unnamed: R12.2, U7.17 (GPIO2)
unnamed: R13.2, U8.7 (FA)
unnamed: R5.1, R16.2, U8.3 (FB)
PWR_SWITCH: Q2.1 (G), R20.2, U7.20 (GPIO5)
RTS_USB: J6.3, Q5.2 (E), R25.1, U5.3 (RTS)
RXD_USB: J6.2, U5.5 (RXD), U7.22 (GPIO1/TXD)
SCL: R17.2, U2.28 (PC5), U7.7 (GPIO13)
SDA: R18.2, U2.27 (PC4), U7.6 (GPIO12)
STEP1: A1.15 (STEP), U2.10 (PD6)
STEP2: A2.15 (STEP), U2.2 (PD4)
TXD_USB: J6.1, U5.1 (TXD), U7.21 (GPIO3/RXD)
USBD+: J3.3 (D+), U5.15 (USBD+)
USBD-: J3.2 (D-), U5.16 (USBD-)
VBUS: J3.1 (VBUS), SW1.2 (B)

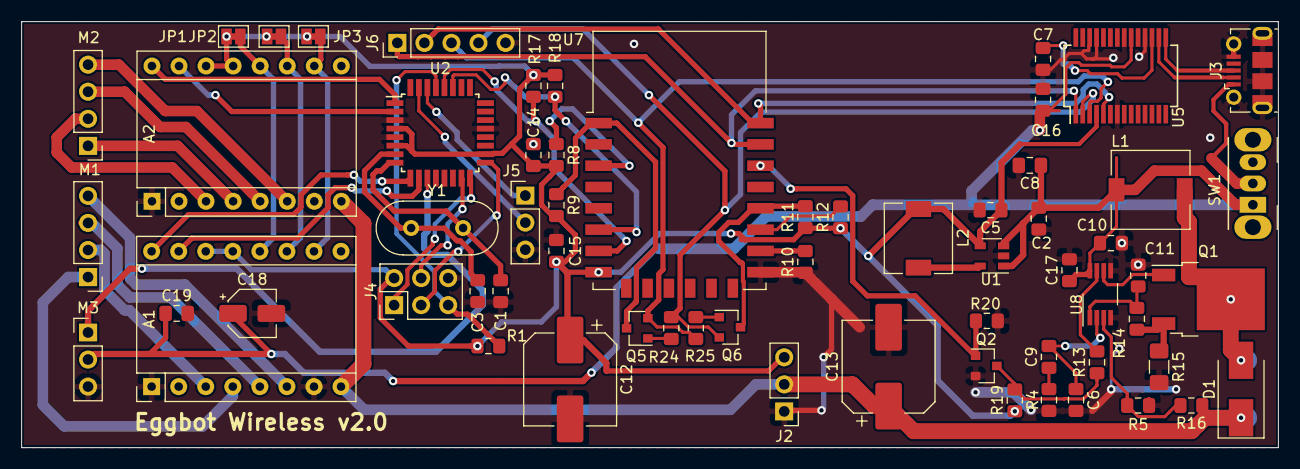
[picture p5: board EggbotWireless.kicad_pcb from above]

Board: 2 copper layers, 118.0 x 40.0 mm, 63 parts (0 on the bottom side), 56 nets.
