usatiuk/EggbotWireless/Firmware/MotorControl/include/Stepper.h

#ifndef STEPPER_H
#define STEPPER_H

class Stepper {
   private:
    int stepsPerRevolution;
    unsigned int stepPin;
    unsigned int dirPin;
    unsigned int remainingSteps;
    float degreesPerMM;
    bool direction;
    void clockwise();
    void counterClockwise();
    float pos = 0;
    int limit;

   public:
    Stepper(int stepPin, int dirPin, int stepsPerRevolution,
            int limit, float degreesPerMM);
    void step(int steps);
    int getRemainingSteps();
    void rotate(float degrees);
    void rotateTo(float degrees);
    void moveTo(float dist);
    void setPos(float degrees);
    float getDist(float degrees);
    int degreesToSteps(float degrees);
    int mmToSteps(float dist);
    void doStep();
    bool finished();
    float getPos();
    float getPosMm();
    float getDistMm(float pos);
};

#endif
