usatiuk/EggbotWireless/Firmware/EggbotWireless/include/WebAPI.h

#ifndef WEB_API_H
#define WEB_API_H

#include <Arduino.h>
#include <ArduinoJson.h>
#include <ESP8266WebServer.h>
#include <LittleFS.h>

class WebAPI {
   private:
    void handleNotFound();
    void handlePutCommand();
    void handleGetStatus();
    void sendCORS();
    bool getFile(String filename);
    String getContentType(String filename);

    String getStatusJson();

   public:
    WebAPI();
    void init();
    void loopRoutine();
};

extern WebAPI webApi;

#endif  // WEB_API_H
