usatiuk/EggbotWireless/(commit log)

2019-05-03 add front/back plates
    [eggbot.FCStd]
2019-05-03 add pen mount plate
    [eggbot.FCStd]
2019-05-03 add stepper egg holder
    [eggbot.FCStd]
2019-05-03 add bearing egg holder
    [eggbot.FCStd]
2019-05-03 design prototype 1
    [eggbot.FCStd]
2019-05-03 remove unnecessaray hole
    [eggbot.FCStd]
2019-05-03 add a ball bearing model
    [eggbot.FCStd]
2019-05-04 some tweaks
    [eggbot.FCStd]
2019-05-04 some more tweaks
    [eggbot.FCStd]
2019-05-04 spring loaded egg
    [eggbot.FCStd]
2019-05-04 tweaks to the marker mount
    [eggbot.FCStd]
2019-05-04 even more tweaks
    [eggbot.FCStd]
2019-05-05 actually kind-of not-completely-broken prototype v0.1
    [eggbot.FCStd]
2019-05-05 tolerance adjustments
    [eggbot.FCStd]
2019-05-06 prototype v0.2
    [eggbot.FCStd]
2019-05-09 timer-driven stepper driver
2019-05-09 stepper backlash compensation
2019-05-09 keep track of stepper's position
2019-05-09 adjust tolerance
    [eggbot.FCStd]
2019-05-09 more tolerance adjustments
    [eggbot.FCStd]
2019-05-09 remove unnecessary Serial.print()
2019-05-09 change servo positions
2019-05-10 more advanced backlash compensation
    [Globals.h, Pen.cpp, Pen.h, Stepper.cpp, Stepper.h, main.cpp]
2019-05-10 fix backlash comp
2019-05-10 disable backlash compensation for servo stepper
    [Globals.h]
2019-05-10 make y axis use nema 17 stepper
    [eggbot.FCStd]
2019-05-10 correct y stepper shaft
    [eggbot.FCStd]
2019-05-10 make x axis use nema17 stepper
    [eggbot.FCStd]
2019-05-10 make pen holder thicker
    [eggbot.FCStd]
2019-05-16 use atmega32 to control stepper motors
2019-05-18 fix pen servo
2019-05-24 start working on schematic
    [EggbotWireless.kicad_pcb, EggbotWireless.sch]
2019-05-24 pcb prototype v0.1 (no steppers yet)
    [EggbotWireless.kicad_pcb, EggbotWireless.sch]
2019-05-24 thicker battery traces
    [EggbotWireless.kicad_pcb]
2019-05-24 change stepper driver to drv8825
    [EggbotWireless.kicad_pcb, EggbotWireless.sch]
2019-05-24 minor board tweaks
    [EggbotWireless.kicad_pcb]
2019-05-24 add steppers to the board
    [EggbotWireless.kicad_pcb, EggbotWireless.sch]
2019-05-24 add branding
    [EggbotWireless.kicad_pcb, EggbotWireless.sch]
2019-05-25 fix servo sizing
    [EggbotWireless.kicad_pcb, eggbot.FCStd]
2019-05-25 fix case
    [eggbot.FCStd]
2019-05-25 fix case (again)
    [eggbot.FCStd]
2019-05-25 add switch to the board
    [EggbotWireless.kicad_pcb, EggbotWireless.sch]
2019-05-25 add a hole for servo wire
    [eggbot.FCStd]
2019-05-25 change atmega16 to atmega32 in schematic
    [EggbotWireless.kicad_pcb, EggbotWireless.sch, eggbot.FCStd]
2019-05-26 hide stepper screws
    [eggbot.FCStd]
2019-05-26 fix screw hole in stepper servo holder
    [eggbot.FCStd]
2019-05-26 fix lower servo screw hole
    [eggbot.FCStd]
2019-05-26 use m4 screw for pen holder
    [eggbot.FCStd]
2019-05-26 place egg higher
    [eggbot.FCStd]
2019-05-26 better pcb mount
    [EggbotWireless.kicad_pcb, eggbot.FCStd]
2019-05-26 proper 12v shutdown circuit
    [EggbotWireless.kicad_pcb, EggbotWireless.sch]
2019-05-26 fix shutdown circuit
    [EggbotWireless.kicad_pcb, EggbotWireless.sch]
2019-05-26 tighter fit for StepperEgg
    [eggbot.FCStd]
2019-05-27 add screw hole to StepperEgg
    [eggbot.FCStd]
2019-05-27 better fit for StepperEgg
    [eggbot.FCStd]
2019-05-28 pcb proto v1
    [EggbotWireless.kicad_pcb]
2019-05-28 make it work with drv8825 driver
2019-05-28 some adjustments to stepper control mechanism
2019-05-29 fix an annoying bug
    [Globals.h, main.cpp]
2019-05-29 a better pen holder
    [eggbot.FCStd]
2019-06-19 use ft232rl for usb ic, better power handling
    [EggbotWireless.kicad_pcb, EggbotWireless.sch]
2019-06-19 add uart pin header for esp12
    [EggbotWireless.kicad_pcb, EggbotWireless.sch]
2019-06-20 pcb v1.1 proto
    [EggbotWireless.kicad_pcb, EggbotWireless.sch]
2019-06-20 use nodemcu reset circuit
    [EggbotWireless.kicad_pcb, EggbotWireless.sch]
2019-07-10 fit code to the new board
2019-07-10 fix issue with ft232rl being powered with rx/tx board v1.1b
    [EggbotWireless.kicad_pcb, EggbotWireless.sch]
2019-07-10 board v1.2 use p-mosfet for charge enable/disable use sleep instead of pwren connect battery to esp adc via voltage divider
    [EggbotWireless.kicad_pcb, EggbotWireless.sch]
2019-07-11 clean up pcb a little bit
    [EggbotWireless.kicad_pcb]
2019-07-13 better mosfets heat dissipation v1.2b
    [EggbotWireless.kicad_pcb]
2019-07-15 fix some power issues
    [EggbotWireless.kicad_pcb, EggbotWireless.sch]
2019-07-15 better crystal routing
    [EggbotWireless.kicad_pcb]
2019-07-15 fix timer interrupt issues
    [main.cpp]
2019-07-15 disable 12v after 20s of inactivity
2019-07-16 board v1.3
    [EggbotWireless.kicad_pcb, EggbotWireless.sch]
2019-07-17 make inductor 6.8uH
    [EggbotWireless.kicad_pcb, EggbotWireless.sch]
2019-07-22 cleanup power handling code
2019-08-05 v1.3f some changes to the schematic
    [EggbotWireless.kicad_pcb, EggbotWireless.sch]
2019-08-05 fix one weird bug
    [GCodeParser.cpp]
2019-08-06 fix servo glitches on low voltage
    [Pen.cpp]
2019-09-07 return actual battery voltage in status
2019-09-13 tighter bearing tolerance
    [eggbot.FCStd]
2019-09-14 fix case pcb stand size
    [eggbot.FCStd]
2019-10-23 specify servo lib as a dependency
2020-01-03 add 5v boost schematic
    [5vBoost.sch, EggbotWireless.kicad_pcb]
2020-01-03 v1.4 beta board (added a 5v boost converter to the board)
    [EggbotWireless.kicad_pcb]
2020-01-26 more detailed egg holder design
    [eggbot.FCStd]
2020-01-26 rubber band tensioner for pen holder
    [eggbot.FCStd]
2020-01-28 change 5vboost inductor to smaller
    [5vBoost.sch, EggbotWireless.kicad_pcb]
2020-02-02 make penHolder hinge gap smaller again (because otherwise servo horn could break it)
    [eggbot.FCStd]
2020-03-17 add a BOM
    [EggbotWirelessBOM.xlsx]
2020-03-18 5vboost working
    [EggbotWireless.kicad_pcb]
2020-03-19 slow down i2c because it didn't work at 1MHz ATMega
    [main.cpp]
2020-03-19 remove pen hotfix now with proper power it should work
2020-03-19 [App] use current window's hostname for api calls
2020-03-19 [Board] fix some issues 1. change 5vboost output capacitor to 68 uF 2. change ATMega crystal to 12MHz
    [5vBoost.sch, EggbotWireless.kicad_pcb, EggbotWireless.sch]
2020-03-19 [AVR] smooth servo
2020-03-19 fix servo not disengaging
    [Pen.cpp]
2020-03-20 [ESP] increase power timeout
2020-07-05 change battery mosfet to FDS6898AZ Servo motor kind of works now, but not enough power for wi-fi, and it resets sometimes: 5v boost redesign needed - I didn't expect that much power draw from a servo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
    [EggbotWireless.sch]
2020-07-06 add 5v booster bypass for servo
    [EggbotWireless.kicad_pcb, EggbotWireless.sch]
2020-07-06 TPS61023 - based 5v booster
    [5vBoost.sch, EggbotWireless.sch]
2020-07-06 add all the new components to the board
    [5vBoost.sch, EggbotWireless.kicad_pcb]
2020-07-06 rename the board to v1.5
    [EggbotWireless.kicad_pcb]
2020-07-07 use Servo library id instead of name because there are multiple "Servo" libraries
2020-11-28 change crystal to 16MHz
    [EggbotWireless.kicad_pcb, EggbotWireless.sch]
2020-12-03 remove all remnants of battery circuitry. Hopefully works
    [EggbotWireless.kicad_pcb, EggbotWireless.sch]
2020-12-06 filet pen holder because otherwise the layers can split
    [eggbot.FCStd]
